renzbagaporo/metalclaw-pico-rp2/3dmodels/HCTL_HC-PZ127-7.2L-2x5PS.step

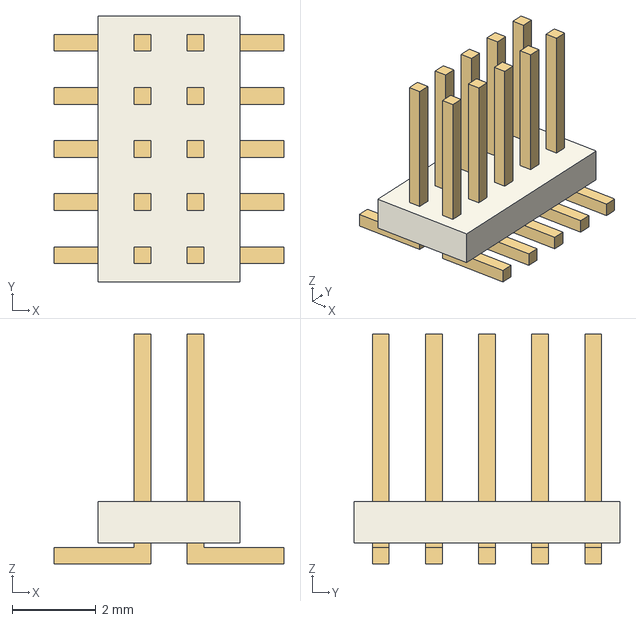
[picture p2: CAD file, 2026-10-25]
3dmodels/HCTL_HC-PZ127-7.2L-2x5PS.step
5.50 x 6.35 x 5.50 mm
