renzbagaporo/metalclaw-pico-rp2/3dmodels/D_SOD-323HE_SS14HE.step

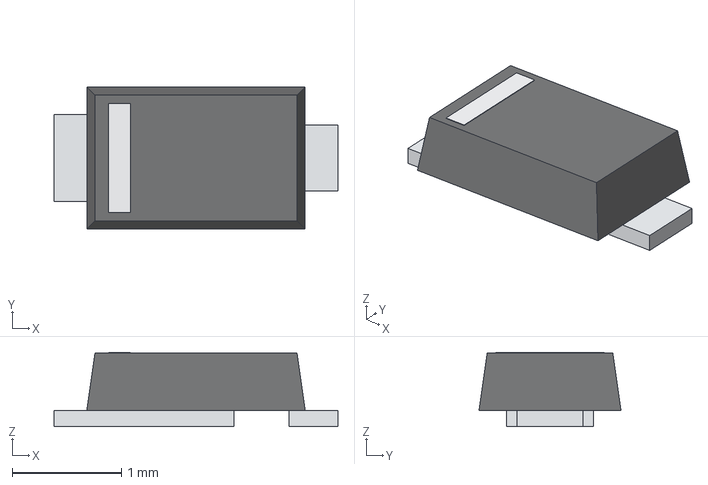
[picture p3: CAD file, 2026-10-24]
3dmodels/D_SOD-323HE_SS14HE.step
2.60 x 1.30 x 0.68 mm
