renzbagaporo/metalclaw-pico-rp2/3dmodels/QFN-80_10x10mm_P0.4mm_EP3.4x3.4mm.step

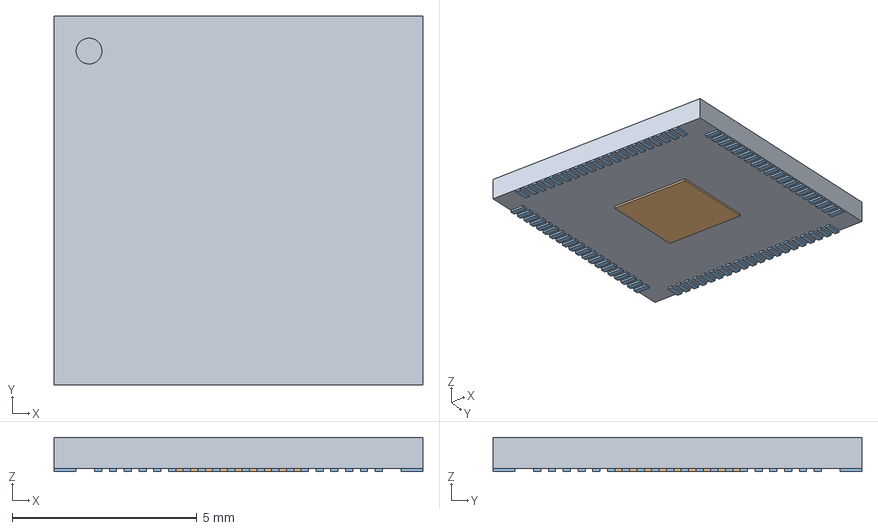
[picture p4: CAD file, 2026-10-24]
3dmodels/QFN-80_10x10mm_P0.4mm_EP3.4x3.4mm.step
10.0 x 10.0 x 0.93 mm
