renzbagaporo/metalclaw-pico-rp2/metalclaw-pico-rp2.kicad_pcb

## KiCad design metalclaw-pico-rp2.kicad_pcb (2026-10-26)

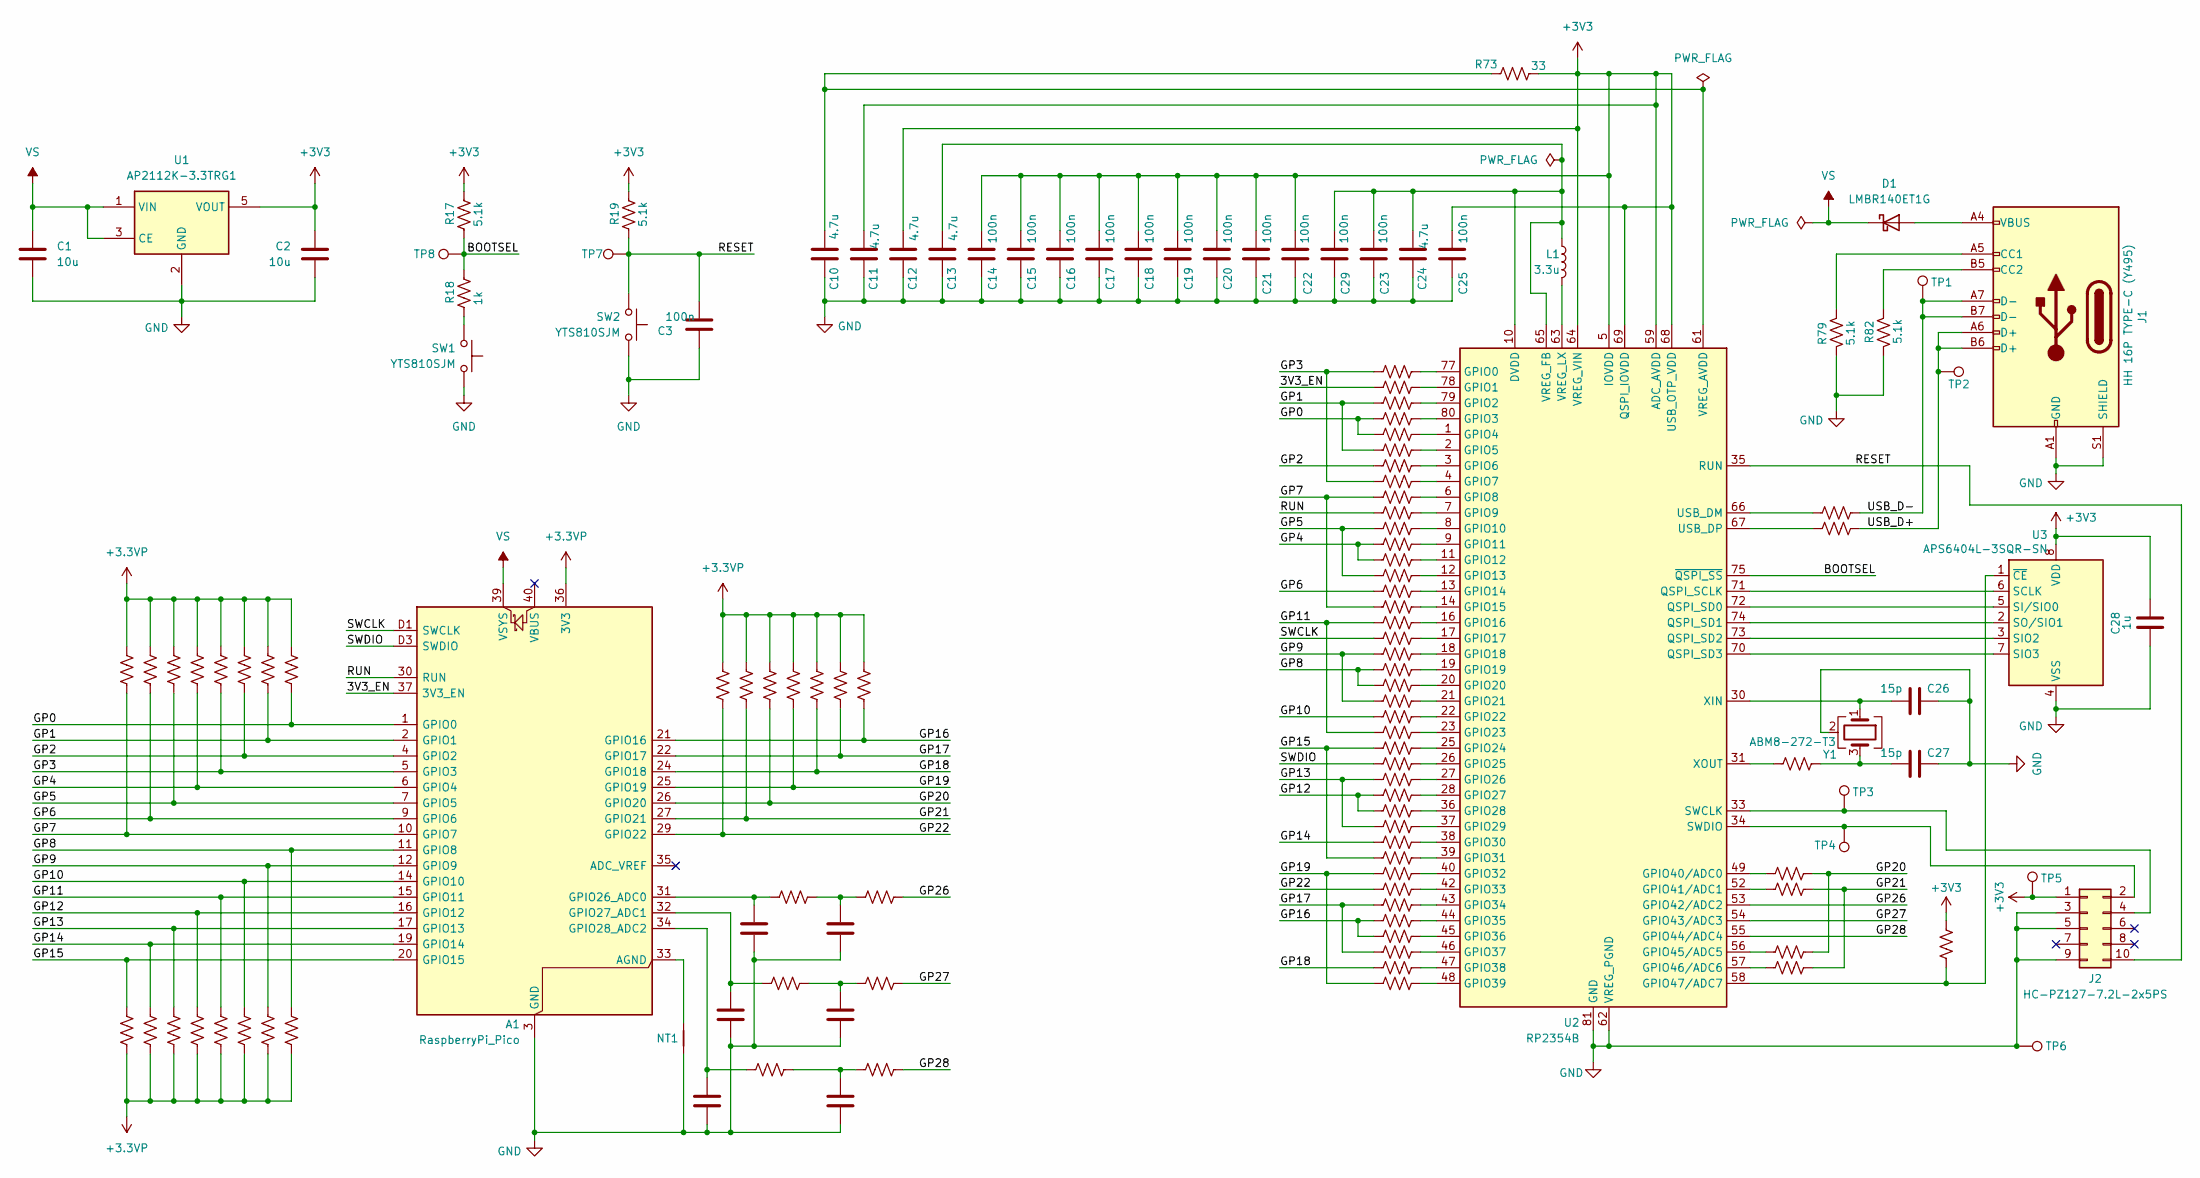
[picture p5: schematic metalclaw-pico-rp2.kicad_sch, MetalClaw Pico RP2]

Parts:
A1: RaspberryPi_Pico; RaspberryPi_Pico_SMD
C1, C2: 10u; C_0603_1608Metric; LCSC C19702
C3, C14, C15, C16, C17, C18, C19, C20, C21, C22, C23, C25, C29: 100n; C_0201_0603Metric; LCSC C190183
C4, C5, C6: 1.5n; C_0402_1005Metric; Mouser 81-GRM1555C1H152JA1D
C7, C8, C9: 10n; C_0201_0603Metric; Mouser 810-C0603X7R1A103K
C10, C11, C12, C13, C24: 4.7u; C_0402_1005Metric; MPN GRM155R60J475ME47D; LCSC C82453
C26, C27: 15p; C_0201_0603Metric; Mouser 81-GRM0335C1H150JA1D
C28: 1u; C_0402_1005Metric; LCSC C52923
D1: LMBR140ET1G; D_SOD-323HE_SS14HE; MPN LMBR140ET1G; LCSC C172430
J1: HH 16P TYPE-C (Y495); USB_C_Receptacle_HH_Y495_16P_TopMnt_Horizontal; MPN HH 16P TYPE-C (Y495); LCSC C52209111
J2: HC-PZ127-7.2L-2x5PS; HCTL_HC-PZ127-7.2L-2x5PS; MPN HC-PZ127-7.2L-2x5PS; LCSC C27985146
L1: 3.3u; L_Abracon_AOTA-B201610S3R3-101-T; Mouser 815-AB201610S3R3101T
NT1: NetTie_2; NetTie-2_SMD_Pad0.5mm
R1, R2, R3, R4, R5, R6, R7, R8, R9, R10, R11, R12, R13, R14, R15, R16, R17, R19, R20, R21, R22, R25, R27, R28, R29, R79, R82: 5.1k; R_0201_0603Metric; Mouser 603-RC0201FR-075K1L
R18, R34, R42, R78: 1k; R_0201_0603Metric; Mouser 603-RC0201FR-071KL
R23, R24, R26, R83: 2.2k; R_0201_0603Metric; Mouser 603-RC0201FR-072K2L
R30, R31, R32: 330; R_0201_0603Metric; Mouser 603-RC0201FR-07330RL
R33, R35, R36, R37, R38, R39, R40, R41, R43, R44, R45, R46, R47, R48, R49, R50, R51, R52, R53, R54, R55, R56, R57, R58, R59, R60, R61, R62, R63, R64, R65, R66, R67, R68, R69, R70, R71, R72, R74, R75, R76, R77: 100; R_0201_0603Metric; Mouser 603-RC0201FR-07100RL
R73: 33; R_0402_1005Metric; Mouser 603-RC0402FR-0733RL
R80, R81: 27; R_0201_0603Metric; MPN WR02X27R0FAL; LCSC C367568
SW1, SW2: YTS810SJM; SW_SPST_PTS810; MPN YTS810SJM; LCSC C2910643
TP1, TP2, TP3, TP4, TP5, TP6, TP7, TP8: TestPoint; TestPoint_Pad_D1.0mm
U1: AP2112K-3.3TRG1; SOT-23-5; MPN AP2112K-3.3TRG1; LCSC C51118
U2: RP2354B; QFN-80_RP2354B_10x10mm_P0.4mm_EP3.4mm_ViaAwarePaste; MPN SC1512(13)-A4; Mouser 358-SC151213
U3: APS6404L-3SQR-SN; SOIC-8_3.9x4.9mm_P1.27mm; MPN APS6404L-3SQR-SN; LCSC C5333729
Y1: ABM8-272-T3; Crystal_SMD_3225-4Pin_3.2x2.5mm; Mouser 815-ABM8-272-T3

Connections:
+3.3VP: A1.36 (3V3), R1.2, R2.1, R3.2, R4.1, R5.2, R6.1, R7.2, R8.1, R9.2, R10.1, R11.2, R12.1, R13.2, R14.1, R15.2, R16.1, R20.2, R21.2, R22.2, R25.2, R27.2, R28.2, R29.2
+3V3: C2.1, C11.2, C12.2, C14.2, C15.2, C16.2, C17.2, C18.2, C19.2, C20.2, C21.2, C22.2, C25.2, C28.1, J2.1, R17.1, R19.1, R73.1, R83.2, TP5.1, U1.5 (VOUT), U2.5 (IOVDD), U2.15 (IOVDD), U2.24 (IOVDD), U2.29 (IOVDD), U2.41 (IOVDD), U2.50 (IOVDD), U2.59 (ADC_AVDD), U2.60 (IOVDD), U2.64 (VREG_VIN), U2.68 (USB_OTP_VDD), U2.69 (QSPI_IOVDD), U2.76 (IOVDD), U3.8 (VDD)
/3V3_EN: A1.37 (3V3_EN), R34.1
/BOOTSEL: R17.2, R18.1, TP8.1, U2.75 (~QSPI_SS)
/GP0: A1.1 (GPIO0), R15.1, R36.1, R37.1
/GP1: A1.2 (GPIO1), R13.1, R35.1, R38.1
/GP2: A1.4 (GPIO2), R11.1, R39.1
/GP3: A1.5 (GPIO3), R9.1, R33.1, R40.1
/GP4: A1.6 (GPIO4), R7.1, R44.1, R45.1
/GP5: A1.7 (GPIO5), R5.1, R43.1, R46.1
/GP6: A1.9 (GPIO6), R3.1, R47.1
/GP7: A1.10 (GPIO7), R1.1, R41.1, R48.1
/GP8: A1.11 (GPIO8), R16.2, R52.1, R53.1
/GP9: A1.12 (GPIO9), R14.2, R51.1, R54.1
/GP10: A1.14 (GPIO10), R12.2, R55.1
/GP11: A1.15 (GPIO11), R10.2, R49.1, R56.1
/GP12: A1.16 (GPIO12), R8.2, R60.1, R61.1
/GP13: A1.17 (GPIO13), R6.2, R59.1, R62.1
/GP14: A1.19 (GPIO14), R4.2, R63.1
/GP15: A1.20 (GPIO15), R2.2, R57.1, R64.1
/GP16: A1.21 (GPIO16), R29.1, R68.1, R69.1
/GP17: A1.22 (GPIO17), R28.1, R67.1, R70.1
/GP18: A1.24 (GPIO18), R27.1, R71.1
/GP19: A1.25 (GPIO19), R25.1, R65.1, R72.1
/GP20: A1.26 (GPIO20), R22.1, R74.2, R76.2
/GP21: A1.27 (GPIO21), R21.1, R75.2, R77.2
/GP22: A1.29 (GPIO22), R20.1, R66.1
/GP26: R30.1, U2.53 (GPIO42/ADC2)
/GP27: R31.1, U2.54 (GPIO43/ADC3)
/GP28: R32.1, U2.55 (GPIO44/ADC4)
/RESET: C3.2, J2.10, R19.2, SW2.2, TP7.1, U2.35 (RUN)
/RUN: A1.30 (RUN), R42.1
/SWCLK: A1.D1 (SWCLK), R50.1
/SWDIO: A1.D3 (SWDIO), R58.1
/USB_D+: J1.A6 (D+), J1.B6 (D+), R81.1, TP2.1
/USB_D-: J1.A7 (D-), J1.B7 (D-), R80.1, TP1.1
GND: A1.3 (GND), A1.8 (GND), A1.13 (GND), A1.18 (GND), A1.23 (GND), A1.28 (GND), A1.38 (GND), A1.D2 (GND), C1.2, C2.2, C3.1, C4.1, C5.1, C6.1, C7.1, C8.1, C9.1, C10.1, C11.1, C12.1, C13.1, C14.1, C15.1, C16.1, C17.1, C18.1, C19.1, C20.1, C21.1, C22.1, C23.1, C24.1, C25.1, C26.2, C27.1, C28.2, C29.1, J1.A1 (GND), J1.A12 (GND), J1.B1 (GND), J1.B12 (GND), J1.S1 (SHIELD), J2.3, J2.5, J2.9, NT1.1, R79.1, R82.1, SW1.1, SW2.1, TP6.1, U1.2 (GND), U2.62 (VREG_PGND), U2.81 (GND), U3.4 (VSS), Y1.2 (G), Y1.4 (G)
unnamed: A1.33 (AGND), NT1.2
unnamed: A1.31 (GPIO26_ADC0), C6.2, R26.2
unnamed: A1.32 (GPIO27_ADC1), C5.2, R24.2
unnamed: A1.34 (GPIO28_ADC2), C4.2, R23.2
unnamed: C7.2, R26.1, R30.2
unnamed: C8.2, R24.1, R31.2
unnamed: C9.2, R23.1, R32.2
unnamed: C27.2, R78.2, Y1.3
unnamed: D1.2 (A), J1.A4 (VBUS), J1.A9 (VBUS), J1.B4 (VBUS), J1.B9 (VBUS)
unnamed: J1.A5 (CC1), R79.2
unnamed: J1.B5 (CC2), R82.2
unnamed: J2.2, TP4.1, U2.34 (SWDIO)
unnamed: J2.4, TP3.1, U2.33 (SWCLK)
unnamed: R18.2, SW1.2
unnamed: R33.2, U2.77 (GPIO0)
unnamed: R34.2, U2.78 (GPIO1)
unnamed: R35.2, U2.79 (GPIO2)
unnamed: R36.2, U2.80 (GPIO3)
unnamed: R37.2, U2.1 (GPIO4)
unnamed: R38.2, U2.2 (GPIO5)
unnamed: R39.2, U2.3 (GPIO6)
unnamed: R40.2, U2.4 (GPIO7)
unnamed: R41.2, U2.6 (GPIO8)
unnamed: R42.2, U2.7 (GPIO9)
unnamed: R43.2, U2.8 (GPIO10)
unnamed: R44.2, U2.9 (GPIO11)
unnamed: R45.2, U2.11 (GPIO12)
unnamed: R46.2, U2.12 (GPIO13)
unnamed: R47.2, U2.13 (GPIO14)
unnamed: R48.2, U2.14 (GPIO15)
unnamed: R49.2, U2.16 (GPIO16)
unnamed: R50.2, U2.17 (GPIO17)
unnamed: R51.2, U2.18 (GPIO18)
unnamed: R52.2, U2.19 (GPIO19)
unnamed: R53.2, U2.20 (GPIO20)
unnamed: R54.2, U2.21 (GPIO21)
unnamed: R55.2, U2.22 (GPIO22)
unnamed: R56.2, U2.23 (GPIO23)
unnamed: R57.2, U2.25 (GPIO24)
unnamed: R58.2, U2.26 (GPIO25)
unnamed: R59.2, U2.27 (GPIO26)
unnamed: R60.2, U2.28 (GPIO27)
unnamed: R61.2, U2.36 (GPIO28)
unnamed: R62.2, U2.37 (GPIO29)
unnamed: R63.2, U2.38 (GPIO30)
unnamed: R64.2, U2.39 (GPIO31)
unnamed: R65.2, U2.40 (GPIO32)
unnamed: R66.2, U2.42 (GPIO33)
unnamed: R67.2, U2.43 (GPIO34)
unnamed: R68.2, U2.44 (GPIO35)
unnamed: R69.2, U2.45 (GPIO36)
unnamed: R70.2, U2.46 (GPIO37)
unnamed: R71.2, U2.47 (GPIO38)
unnamed: R72.2, U2.48 (GPIO39)
unnamed: R74.1, U2.49 (GPIO40/ADC0)
unnamed: R75.1, U2.52 (GPIO41/ADC1)
unnamed: R76.1, U2.56 (GPIO45/ADC5)
unnamed: R77.1, U2.57 (GPIO46/ADC6)
unnamed: R83.1, U2.58 (GPIO47/ADC7), U3.1 (~CE)
unnamed: U2.71 (QSPI_SCLK), U3.6 (SCLK)
unnamed: U2.72 (QSPI_SD0), U3.5 (SI/SIO0)
unnamed: U2.74 (QSPI_SD1), U3.2 (SO/SIO1)
unnamed: U2.73 (QSPI_SD2), U3.3 (SIO2)
unnamed: U2.70 (QSPI_SD3), U3.7 (SIO3)
unnamed: R80.2, U2.66 (USB_DM)
unnamed: R81.2, U2.67 (USB_DP)
unnamed: C10.2, R73.2, U2.61 (VREG_AVDD)
unnamed: C13.2, C23.2, C24.2, C29.2, L1.1, U2.10 (DVDD), U2.32 (DVDD), U2.51 (DVDD), U2.65 (VREG_FB)
unnamed: L1.2, U2.63 (VREG_LX)
unnamed: C26.1, U2.30 (XIN), Y1.1
unnamed: R78.1, U2.31 (XOUT)
VS: A1.39 (VSYS), C1.1, D1.1 (K), U1.1 (VIN), U1.3 (CE)

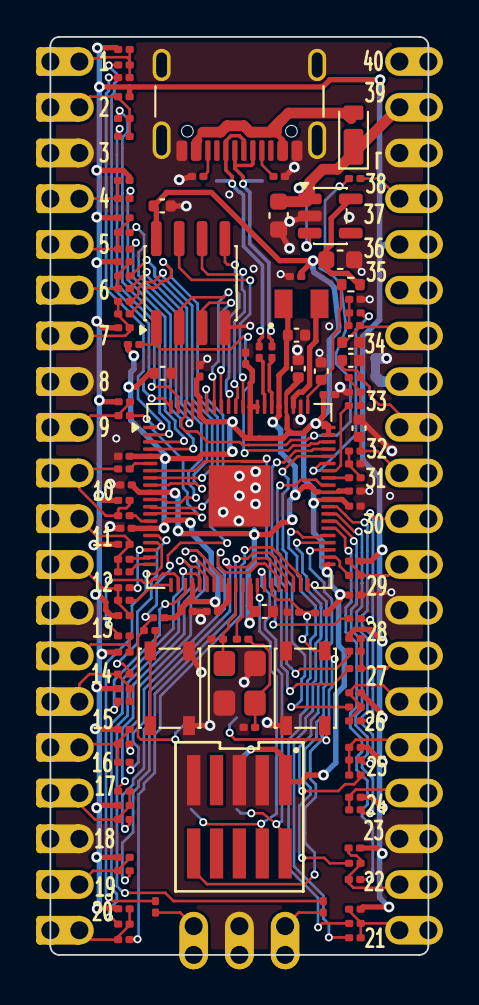
[picture p6: board metalclaw-pico-rp2.kicad_pcb from above]

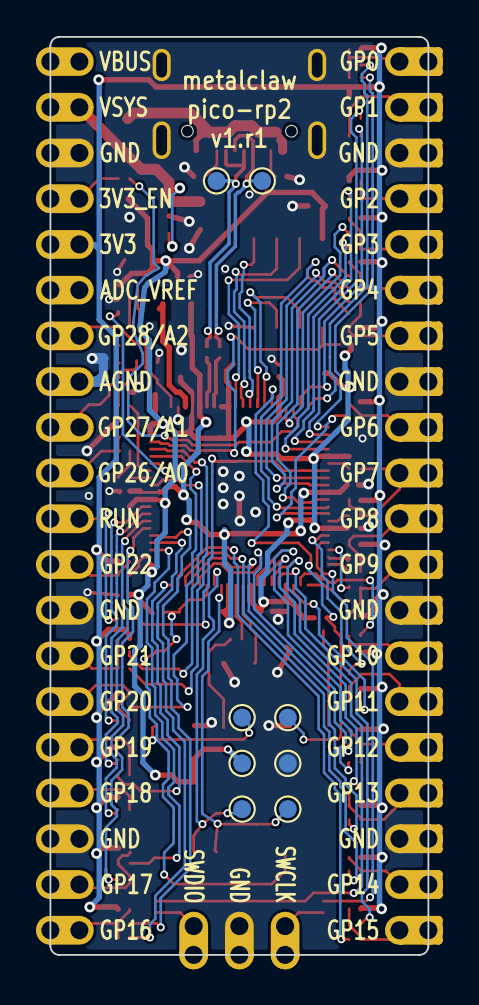
[picture p7: board metalclaw-pico-rp2.kicad_pcb from below]

Board: 4 copper layers, 21.0 x 51.0 mm, 132 parts (9 on the bottom side), 109 nets.
