renzbagaporo/metalclaw-pico-rp2/(commit log)

2026-08-16 Initial schematic connections
    [metalclaw-pico-s2.kicad_pcb, metalclaw-pico-s2.kicad_sch]
2026-08-16 Switch 3V3_EN and RUN pins
    [metalclaw-pico-s2.kicad_sch]
2026-08-18 Specify series resistor resistance and footprint
    [metalclaw-pico-s2.kicad_pcb, metalclaw-pico-s2.kicad_sch]
2026-08-18 Add cap banks to ESP32-S2
    [metalclaw-pico-s2.kicad_sch]
2026-08-18 Add crystal
    [metalclaw-pico-s2.kicad_pcb, metalclaw-pico-s2.kicad_sch]
2026-08-18 Specify SPI flash part and footprint
    [metalclaw-pico-s2.kicad_pcb, metalclaw-pico-s2.kicad_sch]
2026-08-19 Swap SPID and SPIQ wiring to PSRAM and flash chips
    [metalclaw-pico-s2.kicad_pcb, metalclaw-pico-s2.kicad_sch]
2026-08-20 Add more I2C pins
    [metalclaw-pico-s2.kicad_pcb, metalclaw-pico-s2.kicad_sch]
2026-08-20 Rearrange schematic
    [metalclaw-pico-s2.kicad_pcb, metalclaw-pico-s2.kicad_sch]
2026-08-21 Add more I2C pins, JTAG connector
    [metalclaw-pico-s2.kicad_pcb, metalclaw-pico-s2.kicad_sch]
2026-08-21 Add footprint and parts for caps
    [metalclaw-pico-s2.kicad_pcb, metalclaw-pico-s2.kicad_sch]
2026-08-21 Place resistors in rough areas
    [metalclaw-pico-s2.kicad_pcb, metalclaw-pico-s2.kicad_sch]
2026-08-21 Rearrange pins to fit Pi Pico layout
    [metalclaw-pico-s2.kicad_pcb, metalclaw-pico-s2.kicad_sch]
2026-08-21 Add initial Pi Pico footprint
    [metalclaw-pico-s2.kicad_pcb, metalclaw-pico-s2.kicad_sch]
2026-08-21 Add pull-up on CHIP_PU
    [metalclaw-pico-s2.kicad_sch]
2026-08-22 Further refine Pi Pico footprint
    [metalclaw-pico-s2.kicad_pcb]
2026-08-22 Add keepouts for Pi Pico pins
    [metalclaw-pico-s2.kicad_pcb]
2026-08-22 Refine schematic and layout more
    [metalclaw-pico-s2.kicad_pcb, metalclaw-pico-s2.kicad_sch]
2026-08-22 Assign more part numbers
    [metalclaw-pico-s2.kicad_pcb, metalclaw-pico-s2.kicad_sch]
2026-08-22 Remove unecessary symbol fields
    [metalclaw-pico-s2.kicad_pcb, metalclaw-pico-s2.kicad_sch]
2026-08-22 Specify more passive component parts
    [metalclaw-pico-s2.kicad_pcb, metalclaw-pico-s2.kicad_sch]
2026-08-23 Some refinements to schematic and layout
    [metalclaw-pico-s2.kicad_pcb, metalclaw-pico-s2.kicad_sch]
2026-08-23 Fix all ERC errors and warnings
    [metalclaw-pico-s2.kicad_pcb, metalclaw-pico-s2.kicad_sch]
2026-08-23 Update PCB layout
    [metalclaw-pico-s2.kicad_pcb]
2026-08-23 Fix non-board edge DRC errors
    [metalclaw-pico-s2.kicad_pcb]
2026-08-23 Add bypass caps to PSRAM and flash
    [metalclaw-pico-s2.kicad_sch]
2026-08-23 Initial routing left side resistors
    [metalclaw-pico-s2.kicad_pcb, metalclaw-pico-s2.kicad_sch]
2026-08-23 Change I2C pins
    [metalclaw-pico-s2.kicad_pcb, metalclaw-pico-s2.kicad_sch]
2026-08-23 Initial routing of pins
    [metalclaw-pico-s2.kicad_pcb, metalclaw-pico-s2.kicad_sch]
2026-08-23 More initial pin fanout
    [metalclaw-pico-s2.kicad_pcb]
2026-08-26 Add some more routing
    [metalclaw-pico-s2.kicad_pcb]
2026-08-28 Map RP2350B pins
    [metalclaw-pico-s2.kicad_pcb, metalclaw-pico-s2.kicad_sch]
2026-08-29 Connect SPI flash and USB to RP2350B
    [metalclaw-pico-s2.kicad_sch]
2026-08-29 Initial complete RP2350 schematics
    [metalclaw-pico-s2.kicad_sch]
2026-08-29 Re-annotate schematics
    [metalclaw-pico-s2.kicad_sch]
2026-08-29 Rename to metalclaw-pico-rp2
    [metalclaw-pico-rp2.kicad_pcb, metalclaw-pico-rp2.kicad_sch]
2026-08-29 Fix DVDD connections
    [metalclaw-pico-rp2.kicad_sch]
2026-08-29 Fix VREG_AVDD connection
    [metalclaw-pico-rp2.kicad_sch]
2026-08-29 Fix PSRAM chip select connection
    [metalclaw-pico-rp2.kicad_sch]
2026-08-29 Fix power supply connections
    [metalclaw-pico-rp2.kicad_sch]
2026-08-29 Add pull-up for PSRAM chip-select
    [metalclaw-pico-rp2.kicad_sch]
2026-08-29 Connect GP5 with GP1
    [metalclaw-pico-rp2.kicad_sch]
2026-08-29 Fix reset circuit
    [metalclaw-pico-rp2.kicad_sch]
2026-08-29 Connect floating pins on SWD to GND
    [metalclaw-pico-rp2.kicad_sch]
2026-08-29 Add series resistors to USB data lines
    [metalclaw-pico-rp2.kicad_sch]
2026-08-29 Fill in BOM component details
    [metalclaw-pico-rp2.kicad_pcb, metalclaw-pico-rp2.kicad_sch]
2026-08-29 Improve carrier power and RP2354 support circuits
    [metalclaw-pico-rp2.kicad_sch]
2026-08-29 Rip out outdated footprints from layout
    [metalclaw-pico-rp2.kicad_pcb, metalclaw-pico-rp2.kicad_sch]
2026-08-29 Switch to smaller footprints
    [metalclaw-pico-rp2.kicad_pcb, metalclaw-pico-rp2.kicad_sch]
2026-08-29 Move resistors to their rough placements
    [metalclaw-pico-rp2.kicad_pcb]
2026-08-29 Move more components to their rough placements
    [metalclaw-pico-rp2.kicad_pcb]
2026-08-29 Set DRC and netclasses
    [metalclaw-pico-rp2.kicad_pcb]
2026-08-30 More initial rough placement
    [metalclaw-pico-rp2.kicad_pcb]
2026-08-30 Fit all components inside board
    [metalclaw-pico-rp2.kicad_pcb, metalclaw-pico-rp2.kicad_sch]
2026-08-30 Center RP2350B vertically
    [metalclaw-pico-rp2.kicad_pcb]
2026-08-30 Move some components
    [metalclaw-pico-rp2.kicad_pcb]
2026-08-30 Re-annotate schematic
    [metalclaw-pico-rp2.kicad_pcb, metalclaw-pico-rp2.kicad_sch]
2026-08-30 Initial bringout of top half signals and power traces
    [metalclaw-pico-rp2.kicad_pcb]
2026-08-30 Route USB, PSRAM and first quadrant signals
    [metalclaw-pico-rp2.kicad_pcb, metalclaw-pico-rp2.kicad_sch]
2026-09-01 Route next quadrant
    [metalclaw-pico-rp2.kicad_pcb]
2026-09-03 Route third quadrant signals
    [metalclaw-pico-rp2.kicad_pcb]
2026-09-03 Route 3.3V further
    [metalclaw-pico-rp2.kicad_pcb]
2026-09-03 Route 3.3V and RESET
    [metalclaw-pico-rp2.kicad_pcb]
2026-09-04 Do not print reference designators
    [metalclaw-pico-rp2.kicad_pcb]
2026-09-04 Route USB and last quadrant signals
    [metalclaw-pico-rp2.kicad_pcb]
2026-09-04 Route all signals
    [metalclaw-pico-rp2.kicad_pcb, metalclaw-pico-rp2.kicad_sch]
2026-09-04 Rearrange power passives
    [metalclaw-pico-rp2.kicad_pcb, metalclaw-pico-rp2.kicad_sch]
2026-09-05 Fix overlap DRC errors
    [metalclaw-pico-rp2.kicad_pcb]
2026-09-05 Castellate A1 edge pads, fix D1 footprint (US2H), GND stitching, DRC clean
    [metalclaw-pico-rp2.kicad_pcb, metalclaw-pico-rp2.kicad_sch]
2026-09-05 BOM: R83 CE pull-up 10k->2.2k, LCSC part numbers, L1 entry fix
    [metalclaw-pico-rp2.kicad_pcb, metalclaw-pico-rp2.kicad_sch]
2026-09-05 Add GND EP via grid; JLCPCB fab package (gerbers, BOM, CPL), fresh reports
    [metalclaw-pico-rp2.kicad_pcb]
2026-09-13 Add decoupling for pin 51
    [metalclaw-pico-rp2.kicad_pcb, metalclaw-pico-rp2.kicad_sch]
2026-09-13 Add GND return vias for C29 and C9 decoupling loops
    [metalclaw-pico-rp2.kicad_pcb]
2026-09-13 Ground some passives better
    [metalclaw-pico-rp2.kicad_pcb]
2026-09-13 Fix DRC warnings
    [metalclaw-pico-rp2.kicad_pcb]
2026-09-13 Regenerate fab package for C29 and GND via changes
2026-09-13 Use net tie to connect AGND and GND
    [metalclaw-pico-rp2.kicad_pcb, metalclaw-pico-rp2.kicad_sch]
2026-09-13 Fix last warning and regen fab
    [metalclaw-pico-rp2.kicad_pcb, metalclaw-pico-rp2.kicad_sch]
2026-09-14 Add test points for usb and debugger
    [metalclaw-pico-rp2.kicad_pcb, metalclaw-pico-rp2.kicad_sch]
2026-09-14 Fix cap value
    [metalclaw-pico-rp2.kicad_pcb, metalclaw-pico-rp2.kicad_sch]
2026-09-14 Add silkscreen for product name and version
    [metalclaw-pico-rp2.kicad_pcb]
2026-10-24 Add missing component 3D models
    [QFN-80_10x10mm_P0.4mm_EP3.4x3.4mm.step, metalclaw-pico-rp2.kicad_pcb]
2026-10-24 Update JLCPCB component sourcing and fabrication package
    [metalclaw-pico-rp2.kicad_pcb, metalclaw-pico-rp2.kicad_sch]
2026-10-24 Correct assembly footprints and prepare JLCPCB manufacturing package
    [metalclaw-pico-rp2.kicad_pcb, metalclaw-pico-rp2.kicad_sch]
2026-10-24 Correct SS14HE body outline and add package-specific 3D models
    [D_SOD-323HE_SS14HE.step, metalclaw-pico-rp2.kicad_pcb]
2026-10-24 Improve regulator copper clearance and local ground returns
    [metalclaw-pico-rp2.kicad_pcb]
2026-10-24 Prepare v1.r1 documentation and release workflow
    [metalclaw-pico-rp2.kicad_pcb, metalclaw-pico-rp2.kicad_sch]
2026-10-25 Select compact keyed Samtec SWD header for JLCPCB assembly
    [metalclaw-pico-rp2.kicad_pcb, metalclaw-pico-rp2.kicad_sch]
2026-10-25 Reduce assembly BOM cost and add unshrouded SWD orientation outline
    [HCTL_HC-PZ127-7.2L-2x5PS.step, metalclaw-pico-rp2.kicad_pcb, metalclaw-pico-rp2.kicad_sch]
2026-10-25 Qualify regulator capacitors and finalize prototype release sourcing
    [metalclaw-pico-rp2.kicad_pcb, metalclaw-pico-rp2.kicad_sch]
2026-10-25 Correct JLC placement rotations for the selected assembly parts
    [gen_fab.py, test_gen_fab.py]
2026-10-25 Audit every JLC placement and correct USB and diode placement datums
    [gen_fab.py, test_gen_fab.py]
2026-10-25 Refresh public guides and board graphics; keep engineering reviews local
2026-10-25 Add Pico-style pin labels to front and back silkscreen
    [metalclaw-pico-rp2.kicad_pcb]
2026-10-26 Align front pin numbering and refine back silkscreen labels
    [metalclaw-pico-rp2.kicad_pcb]
2026-10-26 Add six ground return vias and refresh board illustrations
    [metalclaw-pico-rp2.kicad_pcb]
